xym-ee/data-collector-rt/README.md

更多介绍查看我的个人主页项目介绍[搭载于密闭环境检测无人机的环境数据采集与上报模块](https://xym.work/blog/data-collector-rt.html)

一个基于 STM32F407 的环境数据采集与上报模块。该模块通过外挂的 W5500 芯片与无人机局域网内的机载工控机进行通信，采用 UDP 协议实现数据传输。

[](./images/1-2.png)

---

2023-07 板的最终代码调试记录

转发板 IP ：192.168.144.55  作为服务器的端口为 5500
转发板连接到 192.168.144.115:5501

测距雷达，通过串口连接上位机，修改为 IIC 模式
- 1.设置为IIC模式 5A 05 0A 01 6A
- 2.修改IIC从机地址 5A 05 0B ADD SUM
    - 5A 05 0B 50 BA
    - 5A 05 0B 51 BB
    - 5A 05 0B 52 BC
- 3.保存设置 5A 04 11 6F

- UART1     气体传感器1
- UART2     气体传感器2
- UART3     
- UART4     
- UART5     SBUS
- UART6     MSH

- IIC3      SCL_PA8     SDA_PC9
  - 温度传感器   0x18
  - 距离传感器1  0x50
  - 距离传感器2  0x51
  - 距离传感器3  0x52

调试记录

控制电源全部打开

UDP发送 55 55 01 04 01 03 7f 00 32

控制电源全部关闭

UDP发送 55 55 01 04 00 00 00 00 af

控制灯灯光全部开启

UDP发送 55 55 02 04 00 ff 00 00 af

控制灯光全部关闭

UDP发送 55 55 02 04 00 00 00 00 b0
