xym-ee/data-collector-rt/202307-原理图.pdf

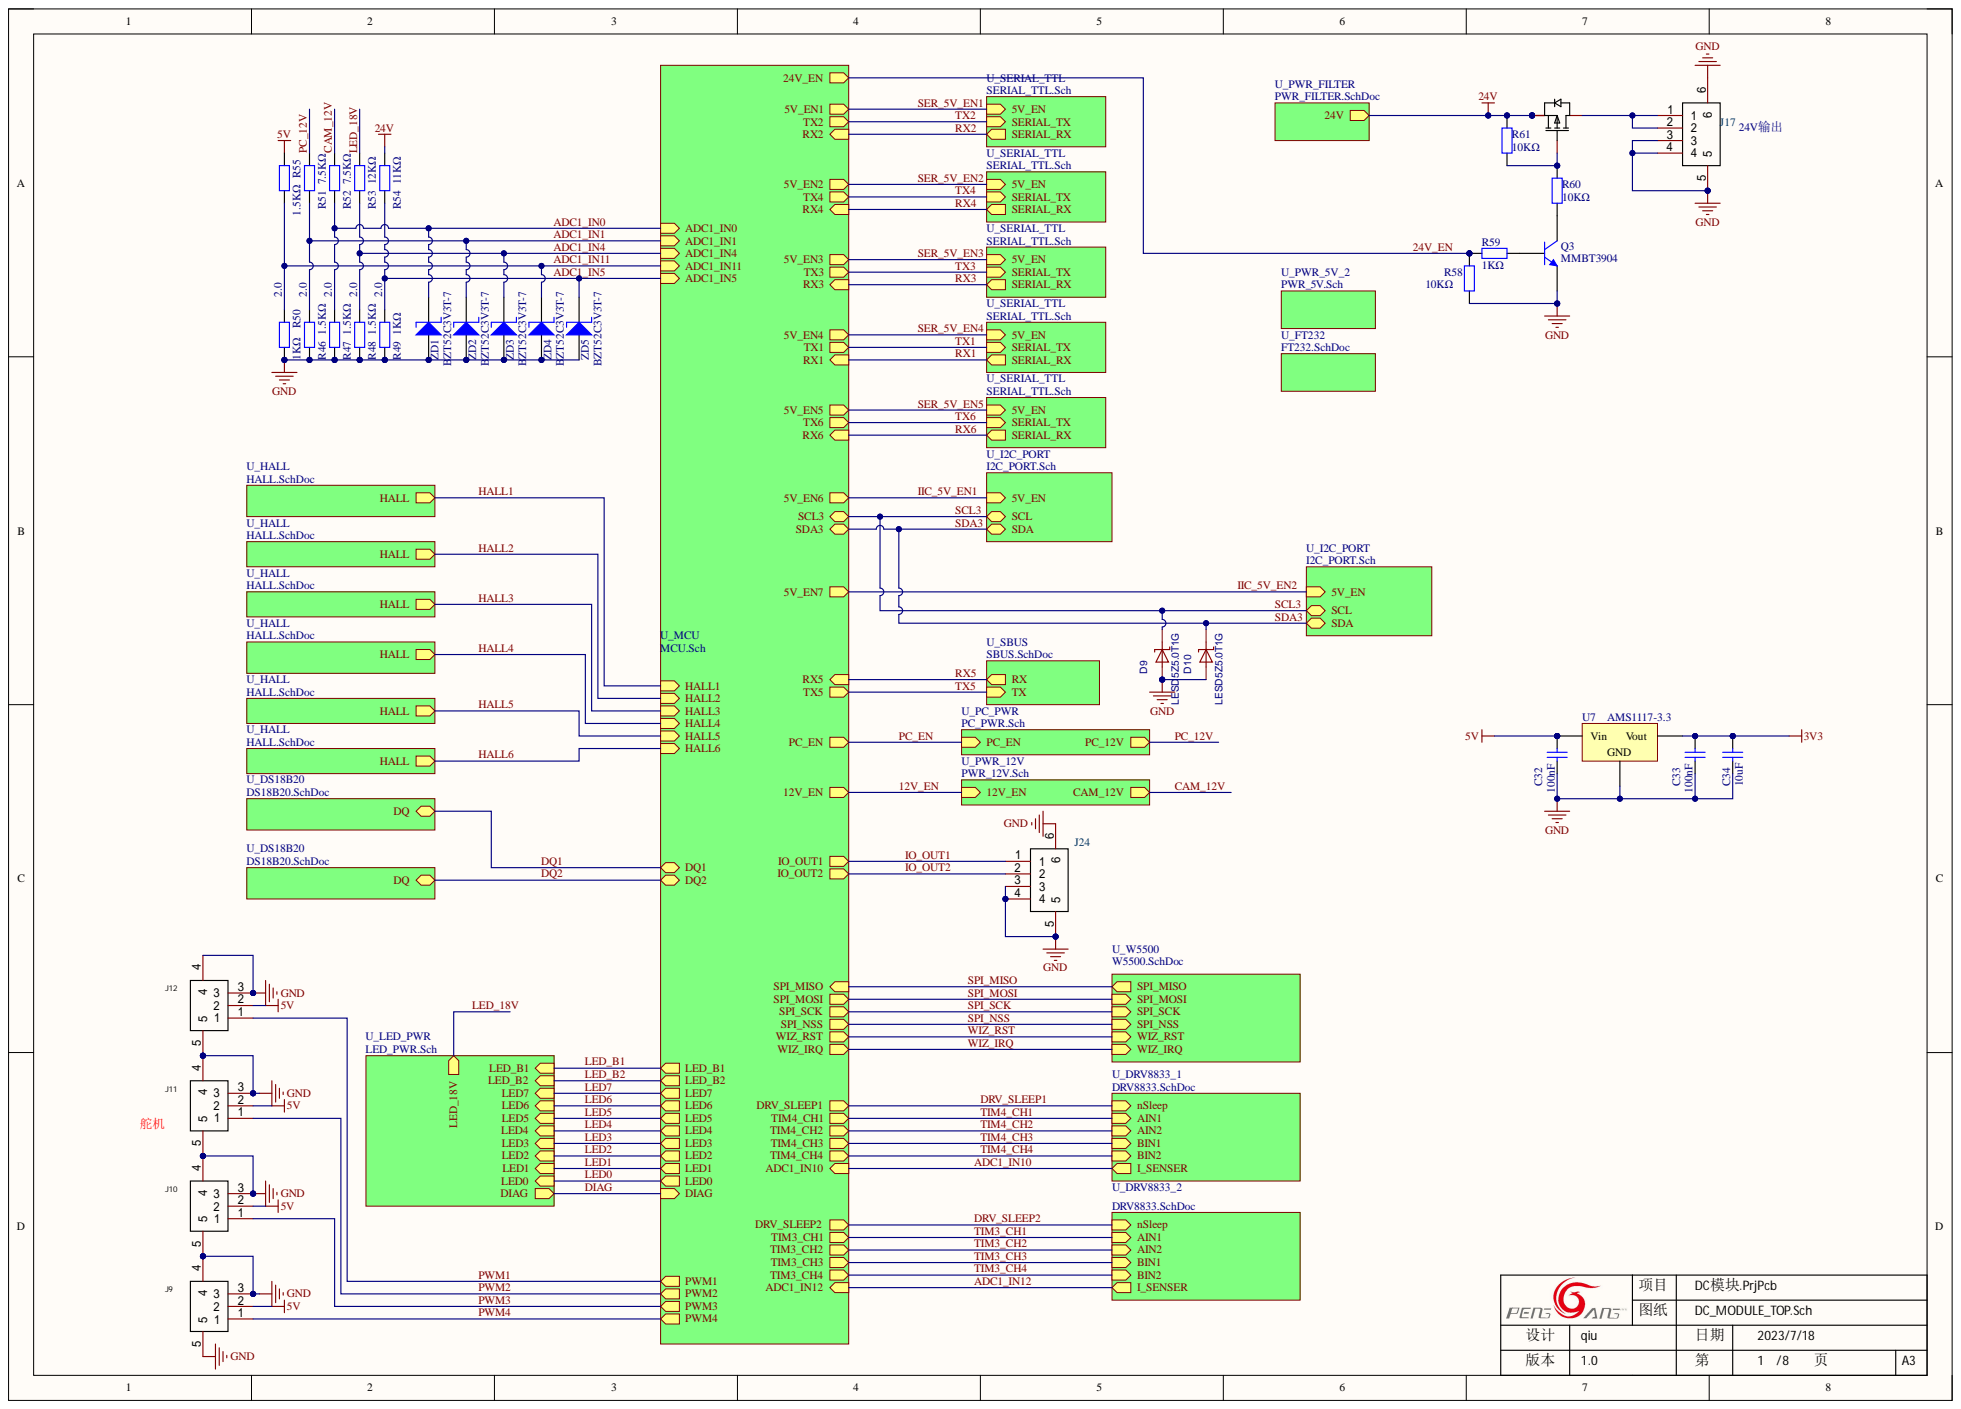
[picture p14: page 1]

A D C1_I N 4
A D C1_I N 1 1 | SE R_5V_E N 3 | 5V_E N SE R I A L_T X SE R I A L_R X
A D C1_I N 5 | R X 3

U_L E D_PWR L E D_PWR.Sch | SPI_NSS

L E D 3 | T IM4_C H 3
L E D 2 | T IM4_C H 4
L E D 1 | A D C1_I N10

设计 | qi u | 日期 | LE_TOP.Sch /8 3/7/1

图纸 | DC_MODU

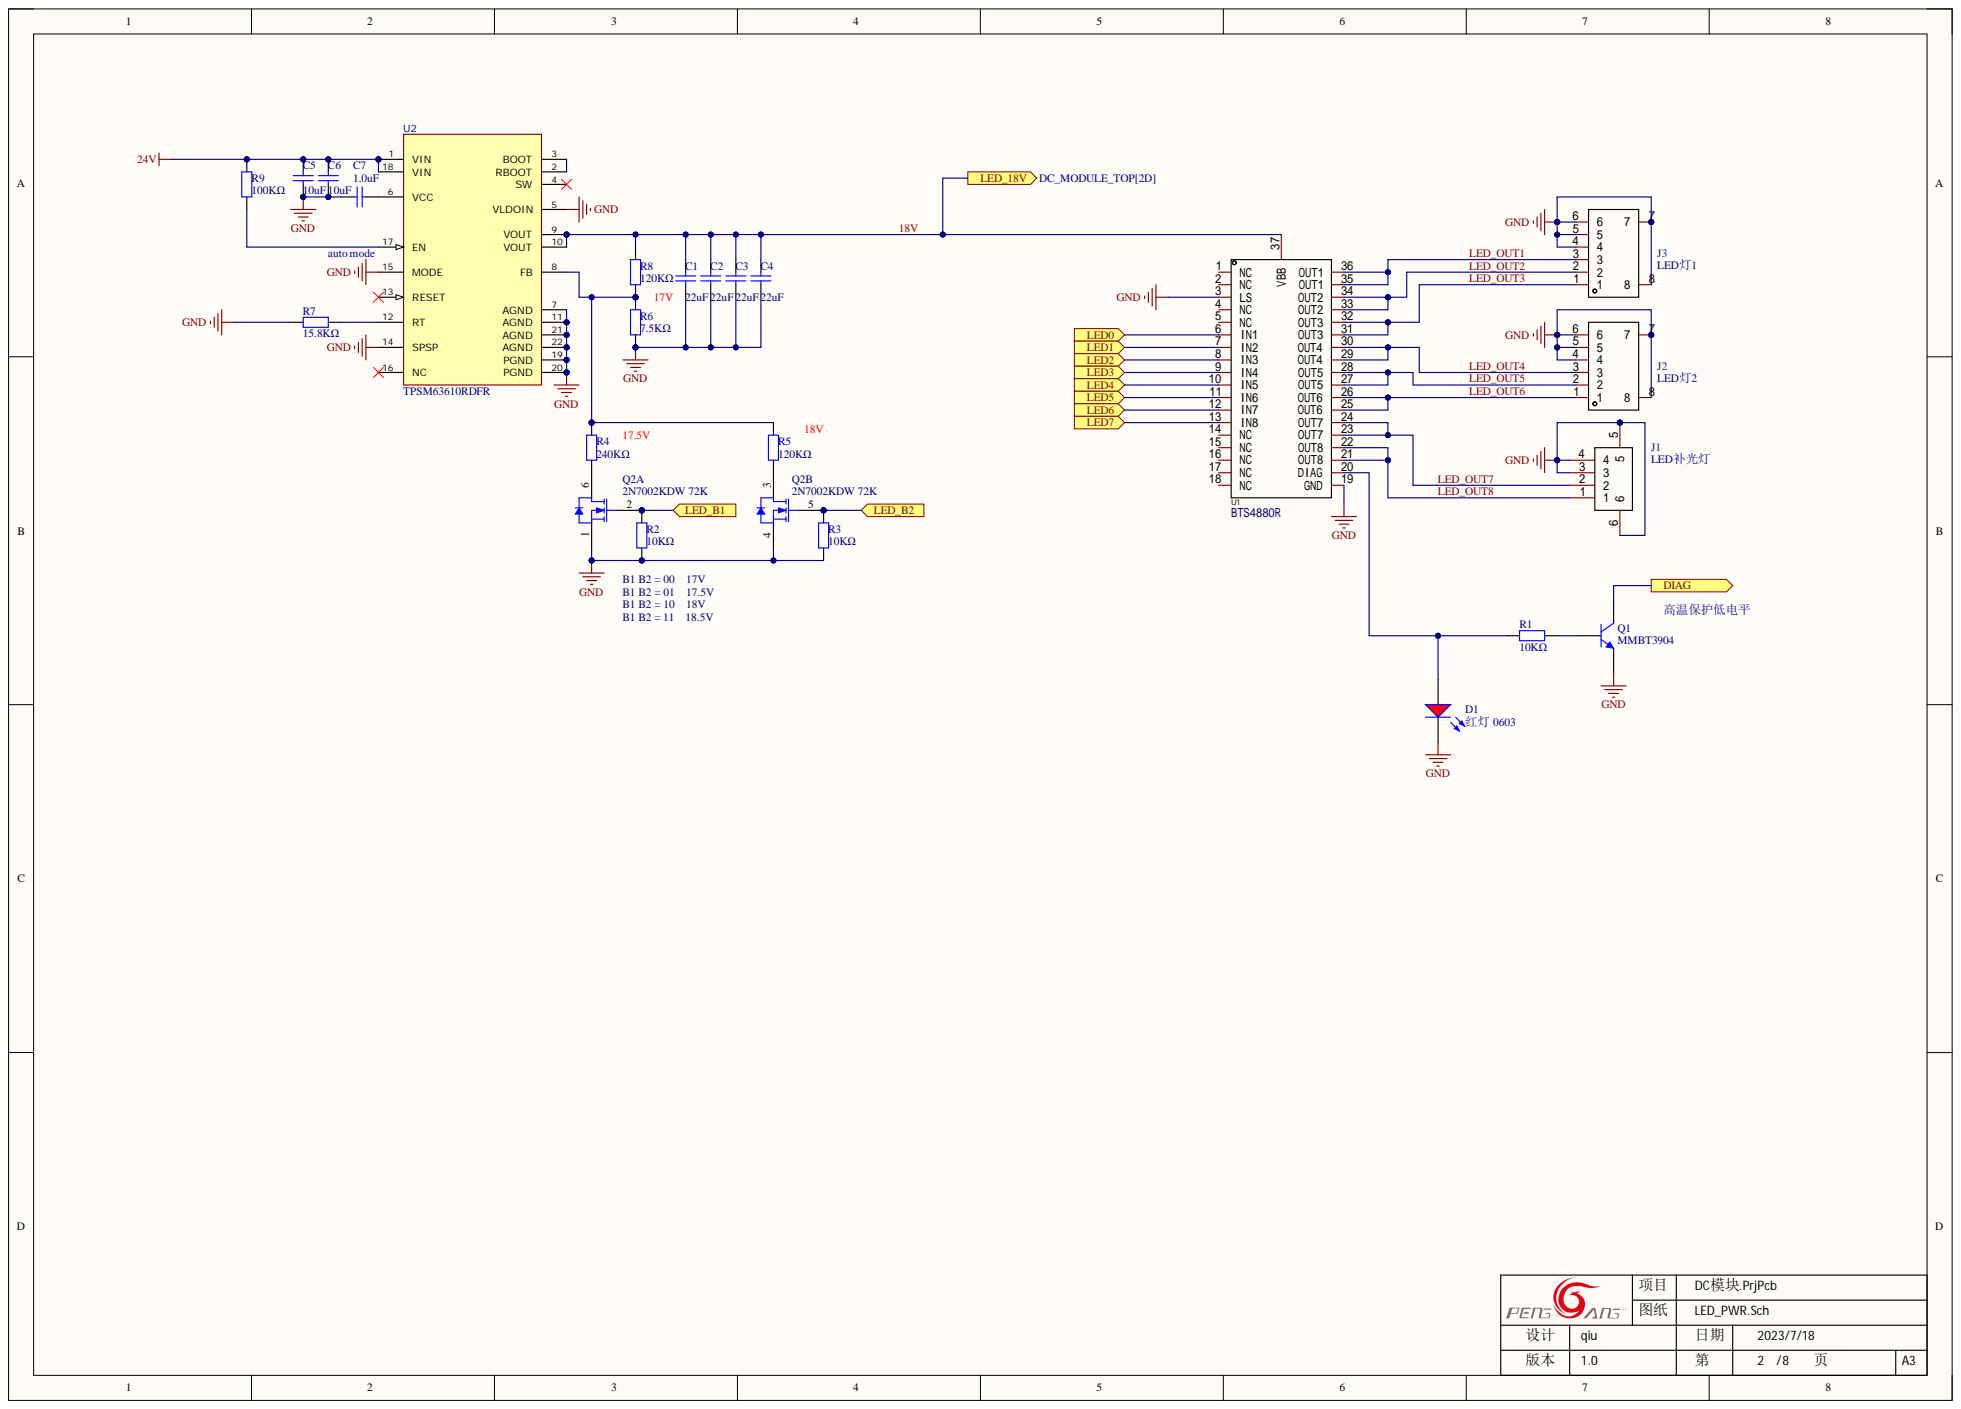
[picture p15: page 2]

L E D_O U T 5
L E D_O U T 6

项目 | DC模块 .PrjPcb
图纸 | LED_PW R.Sch

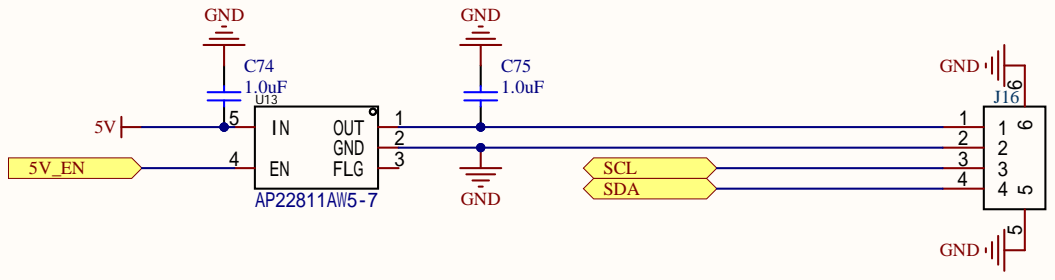
[picture p16: page 3]

项目 | D C模块 . Prj Pcb
图纸 | I2C_PORT.Sch

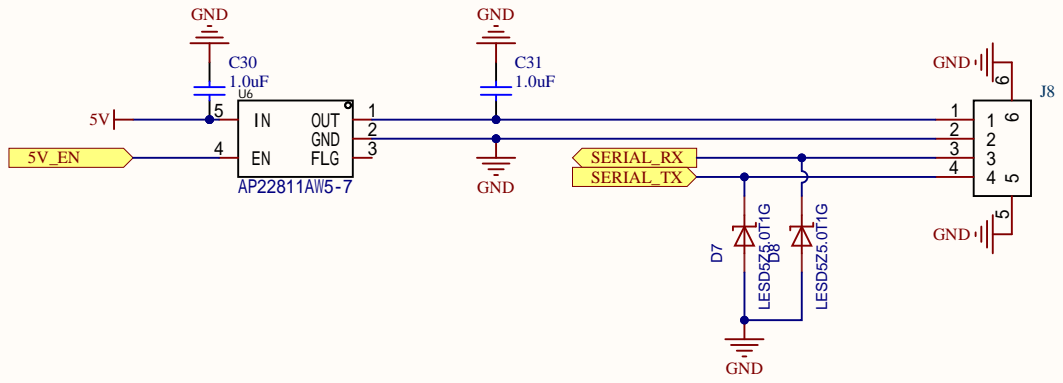
[picture p17: page 4]

项目 | D C模块 . Prj Pcb
图纸 | SE RIA L_TT

设计 | qi u | 日期 | L.Sch/ 2023/7/18

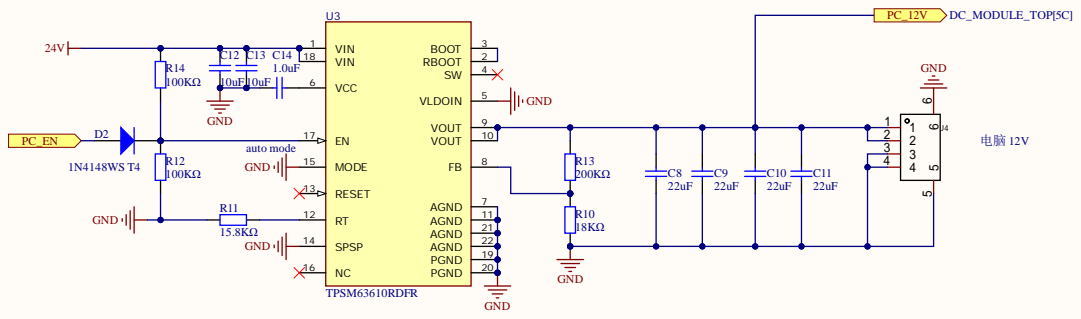
[picture p18: page 5]

项目 | D C模块 . Prj Pcb
图纸 | PC_PW R.Sch

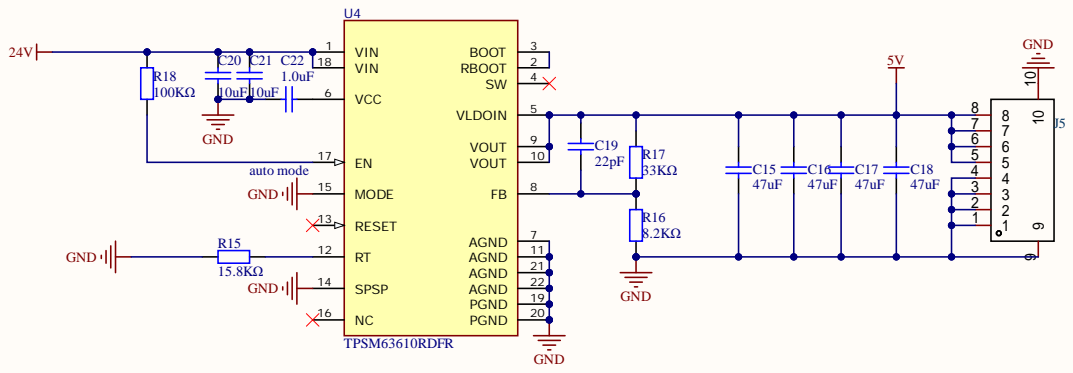
[picture p19: page 6]

项目 | D C模块 . Prj Pcb
图纸 | PW R_5V.Sch

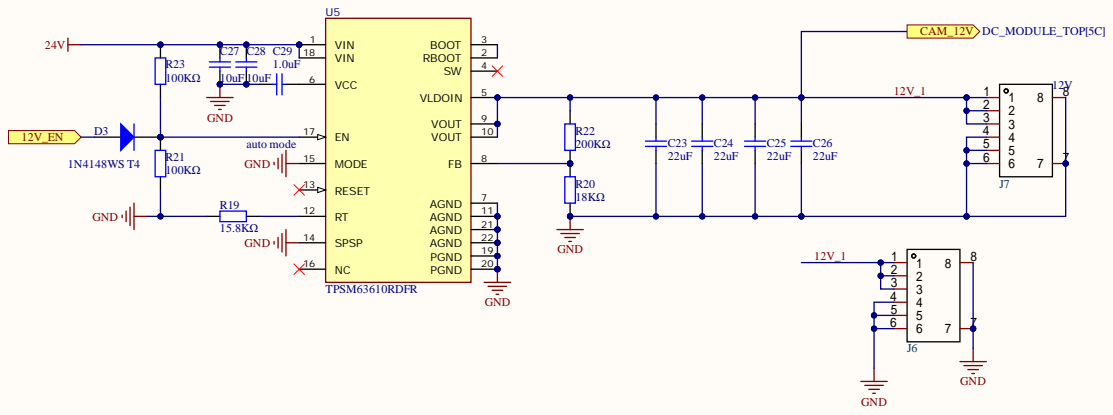
[picture p20: page 7]

项目 | D C模块 . Prj Pcb
图纸 | PW R_12V.Sch

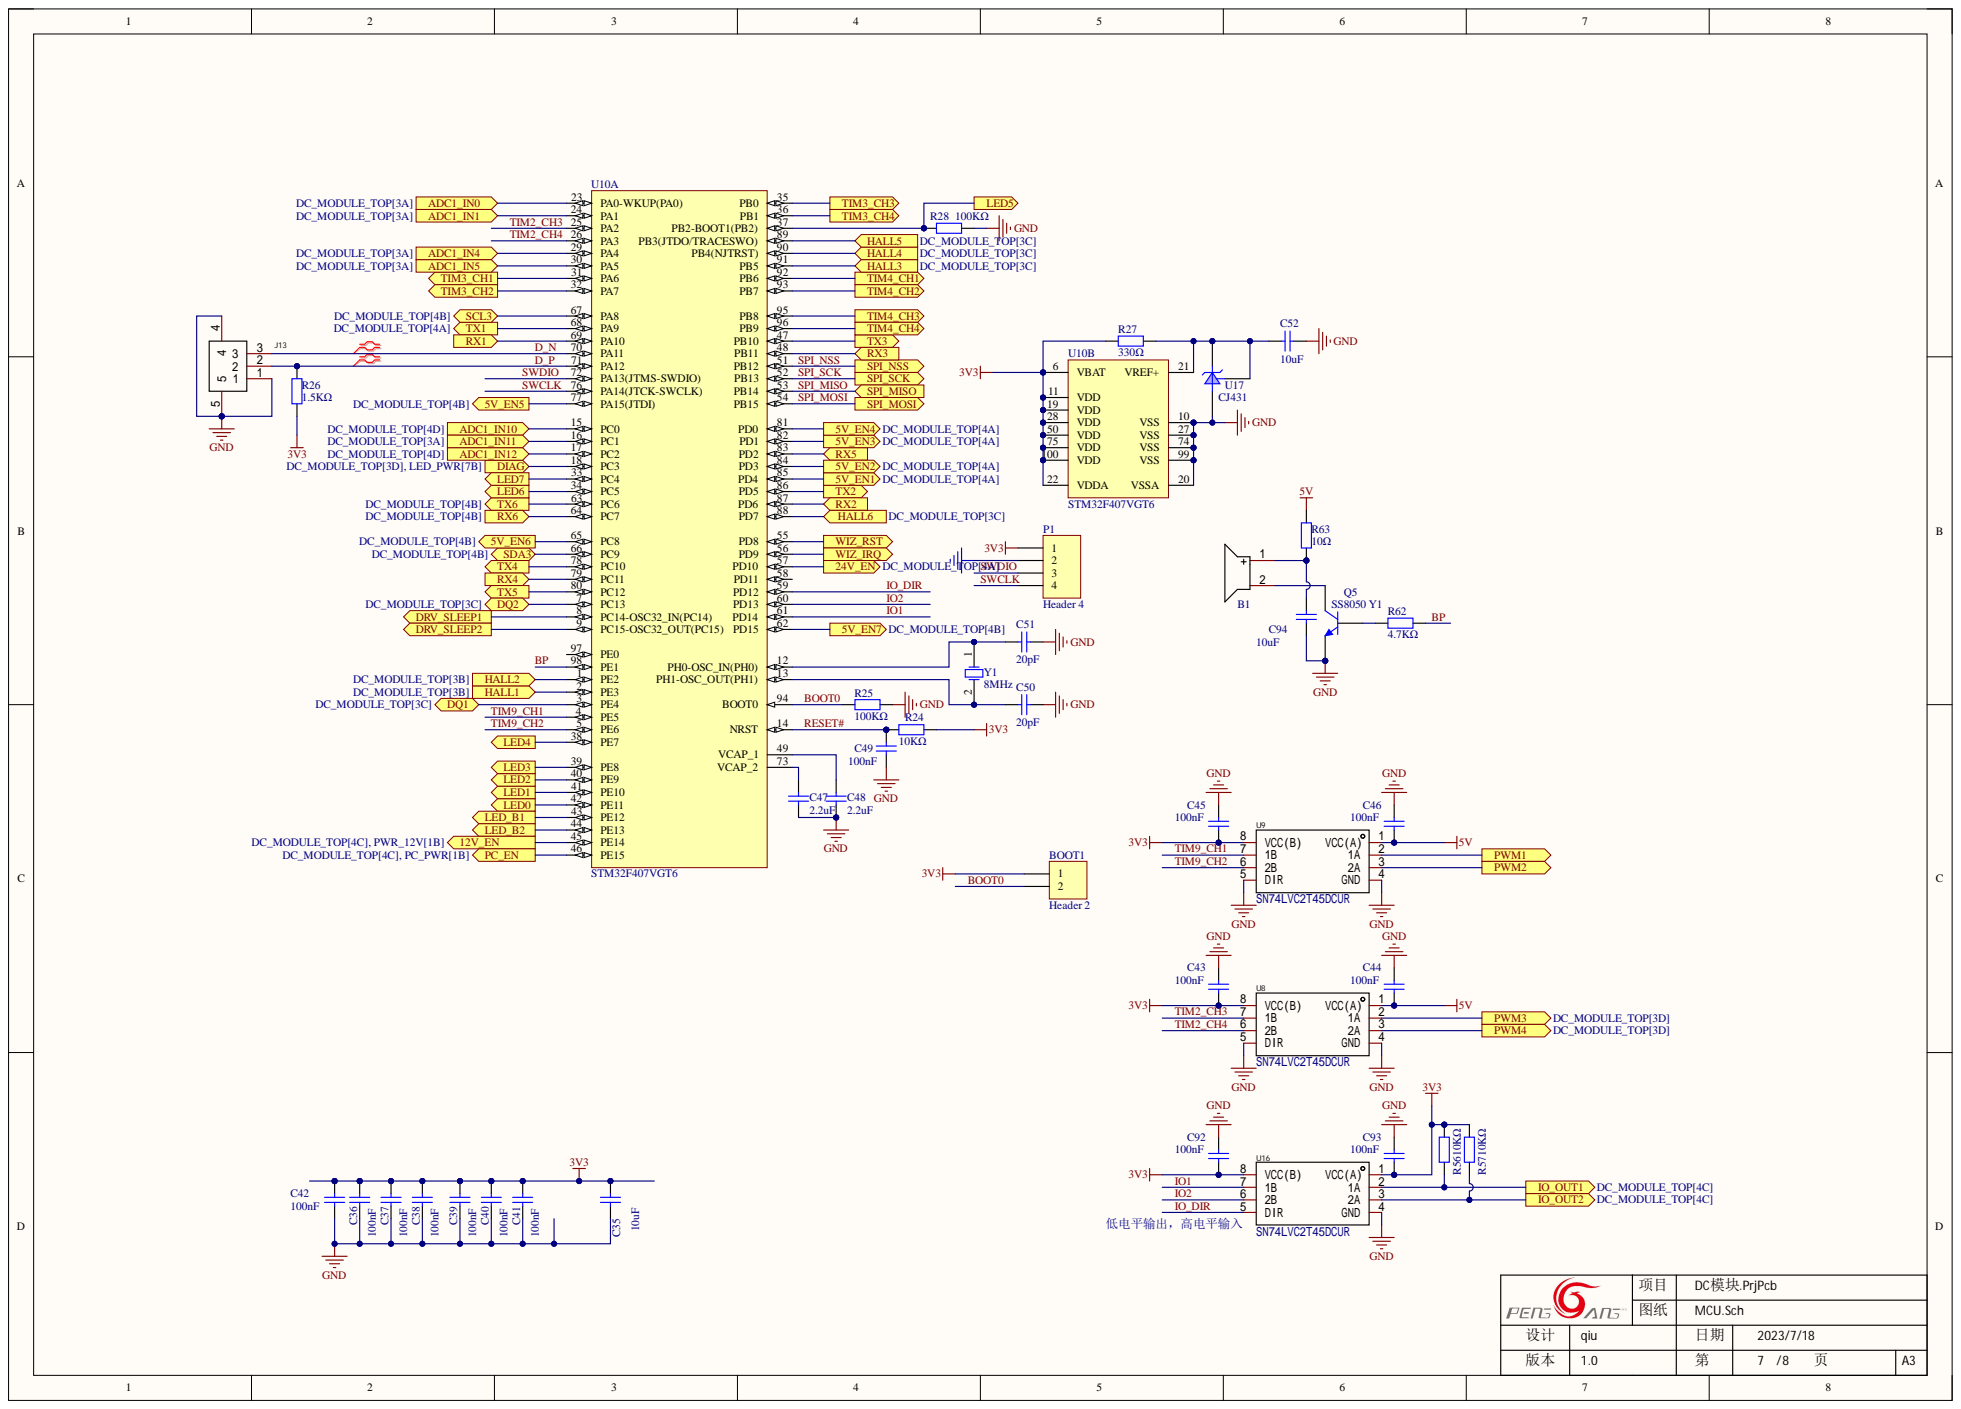
[picture p21: page 8]

项目 | DC模块.PrjPcb
图纸 | MCU.Sch

设计 | qiu | 日期 | 2023/7/18
版本 | 1.0 | 第 | 7 /8 页 | A3

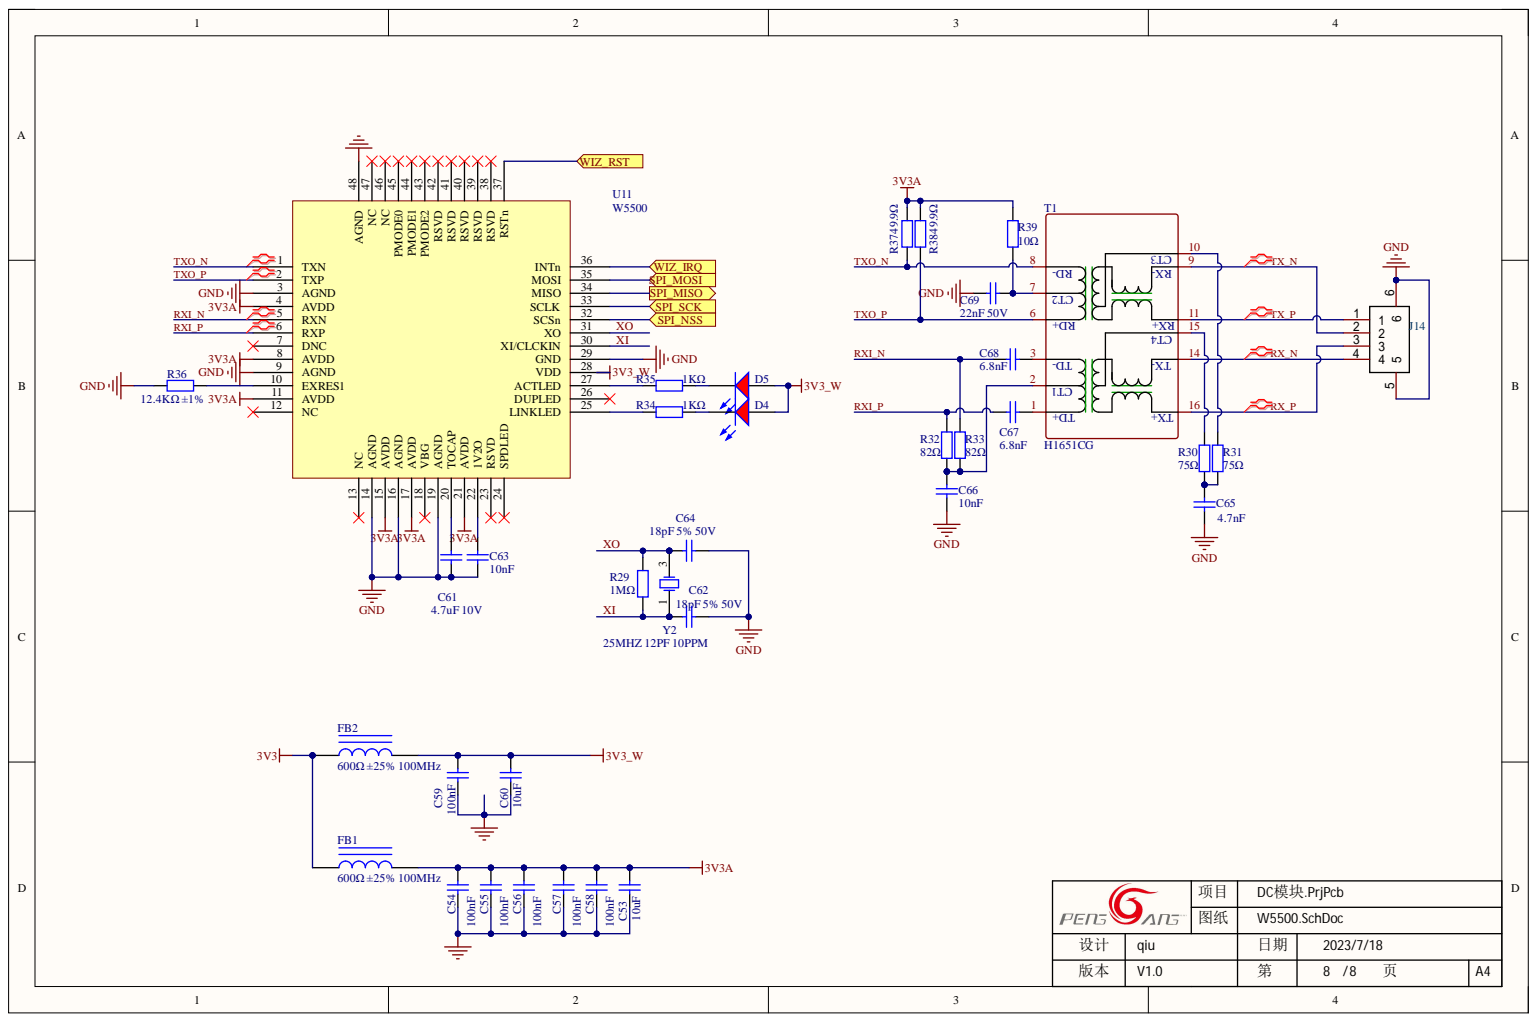
[picture p22: page 9]

RSTn 37 RSVD 38 RSVD 39 RSVD 40 RSVD 41 RSVD 42 PMODE2 43 PMODE1 44 PMODE0 45 NC 46 NC 47 AGND 48

项目 | D C模块 . Prj Pcb
图纸 | W5500.SchD

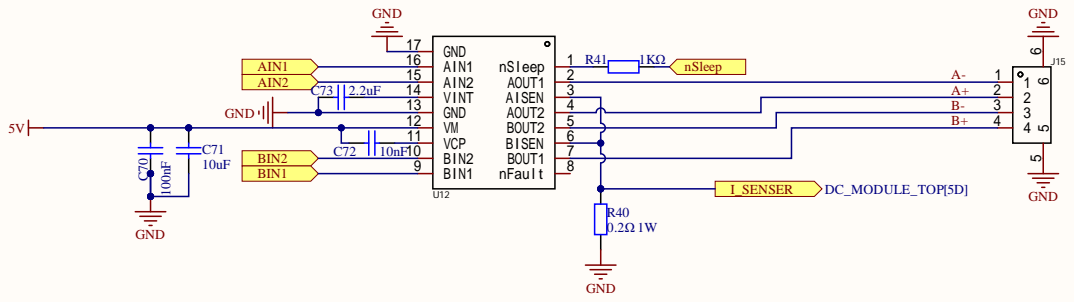
[picture p23: page 10]

B-
B+

项目 | D C模块 . Prj Pcb
图纸 | D RV8833.SchD

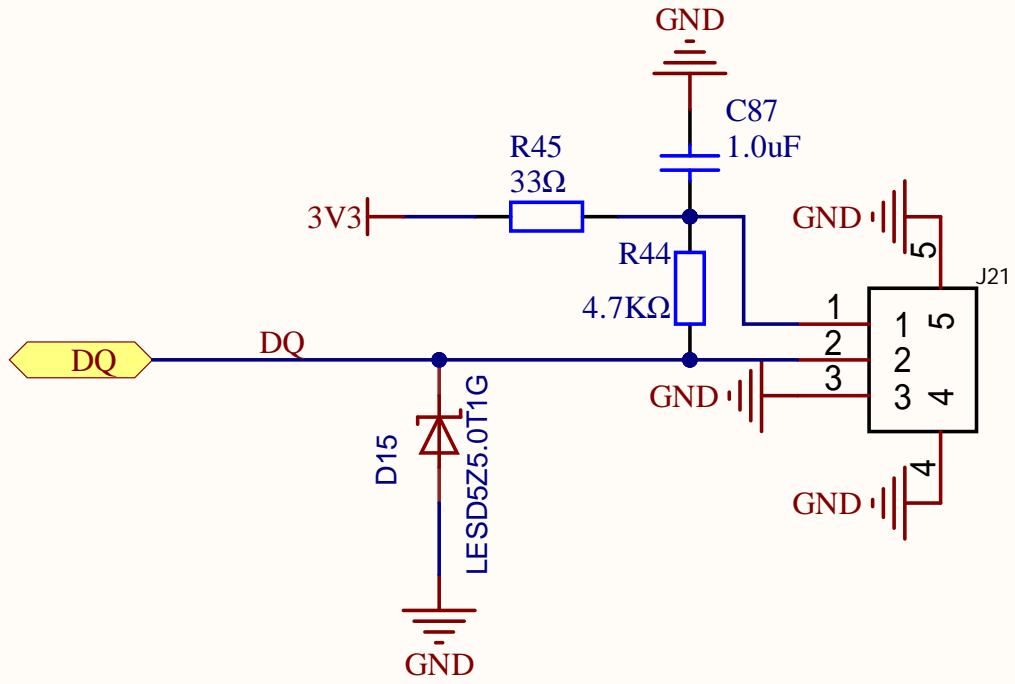
[picture p24: page 11]

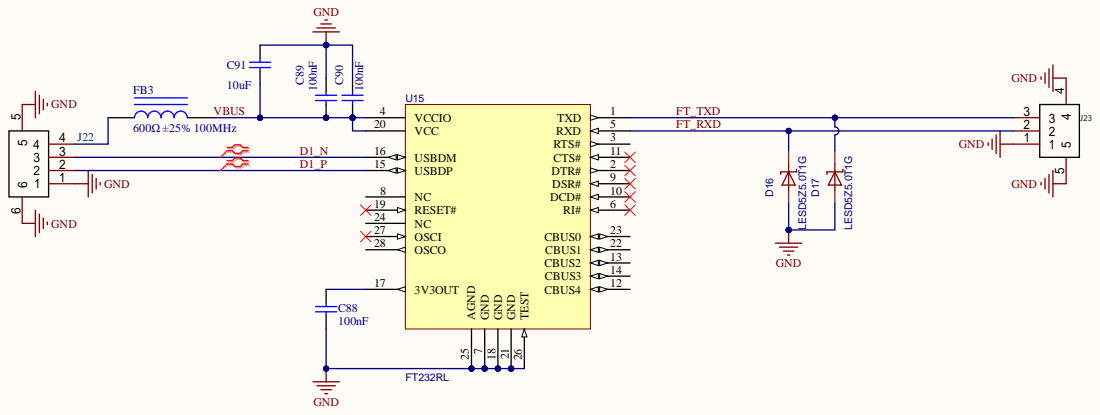
[picture p25: page 12]

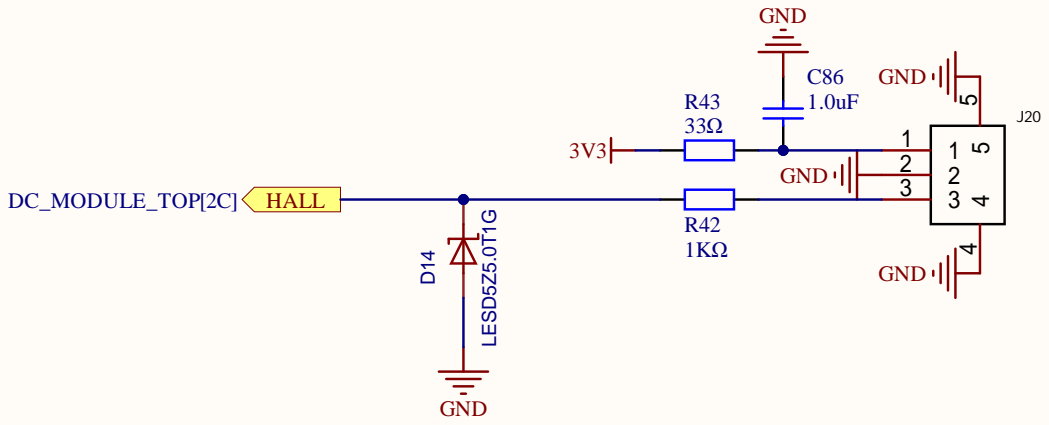
[picture p26: page 13]

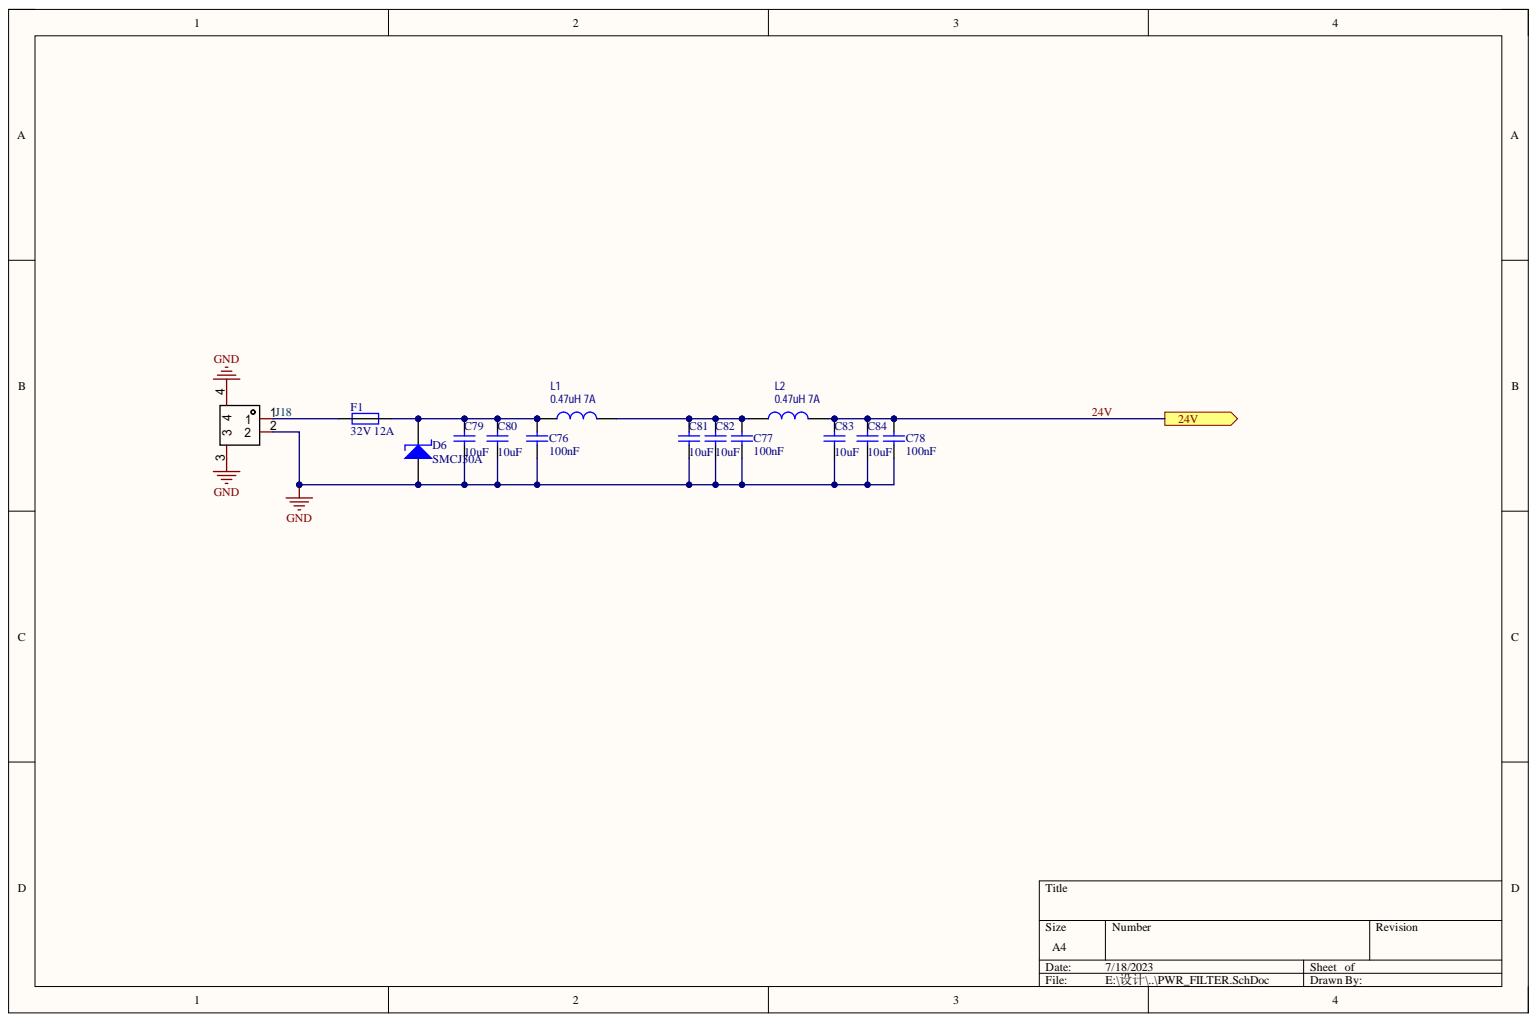
[picture p27: page 14]

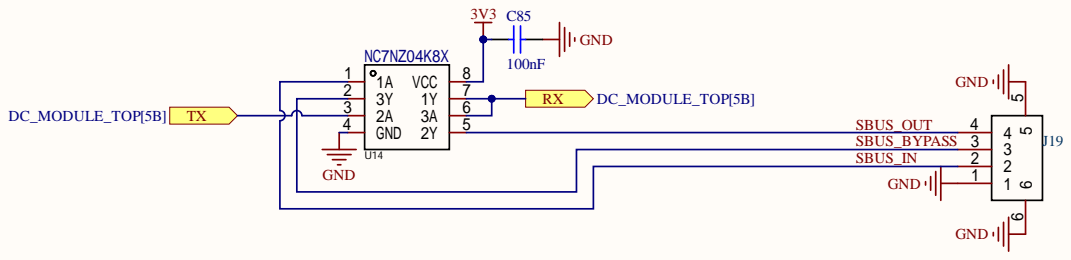
[picture p28: page 15]

GND 2Y | SBUS_ O U T

SBUS_BY PA S S

项目 | D C模块 . Prj Pcb
图纸 | SB US.SchD oc
