xym-ee/data-collector-rt/keil-project/applications/sensor/distance1.h

#ifndef __DISTANCE1_H__
#define __DISTANCE1_H__

#include <rtthread.h>
#include <rtdevice.h>
#include <board.h>


#define DISTANCE1_UART       "uart3"


#define DISTANCE1_THREAD_PRIORITY         5
#define DISTANCE1_THREAD_STACK_SIZE       1024
#define DISTANCE1_THREAD_TIMESLICE        10




#endif
