xym-ee/data-collector-rt/keil-project/applications/sensor/gas2.h

#ifndef __GAS2_H__
#define __GAS2_H__

#include <rtthread.h>
#include <rtdevice.h>
#include <board.h>


#define GAS2_UART_DEV               "uart2"

#define GAS2_RX_PRIORITY           5
#define GAS2_RX_STACK_SIZE         256
#define GAS2_RX_TIMESLICE          5


#endif
