xym-ee/data-collector-rt/keil-project/applications/sensor/distance2.h

#ifndef __DISTANCE_H__
#define __DISTANCE_H__

#include <rtthread.h>
#include <rtdevice.h>
#include <board.h>


#define SBUS_UART       "uart3"


#define SBUS_THREAD_PRIORITY         3
#define SBUS_THREAD_STACK_SIZE       1024
#define SBUS_THREAD_TIMESLICE        10




#endif
