xym-ee/data-collector-rt/keil-project/applications/udp.h

#ifndef __UDP_H__
#define __UDP_H__

#include <rtthread.h>
#include <rtdevice.h>
#include <board.h>




#define UDP_SERVER_IP       "10.0.0.10"
#define UDP_SERVER_PORT     5500


#define     UDP_THREAD_STACK_SIZE   2048
#define     UDP_THREAD_PRIORITY     16
#define     UDP_THREAD_TIMESLICE    10




#endif
