xym-ee/data-collector-rt/(commit log)

2023-09-01 Update arduino_main.cpp, README.md, and 1452 more files...
2023-09-03 MCP9808温度传感器
2023-09-07 Update sensor_gas.c, udpclient.c, and 5 more files...
2024-07-25 更新DC模块-202307.pdf，README.md和2多个文件...
2024-08-28 项目整理
    [kconfig-language.txt, kconfig.txt]
